AeroX2/esphome-fujitsu/pcb/esp-aircon.kicad_pcb

## KiCad design pcb/esp-aircon.kicad_pcb (2024-02-02)

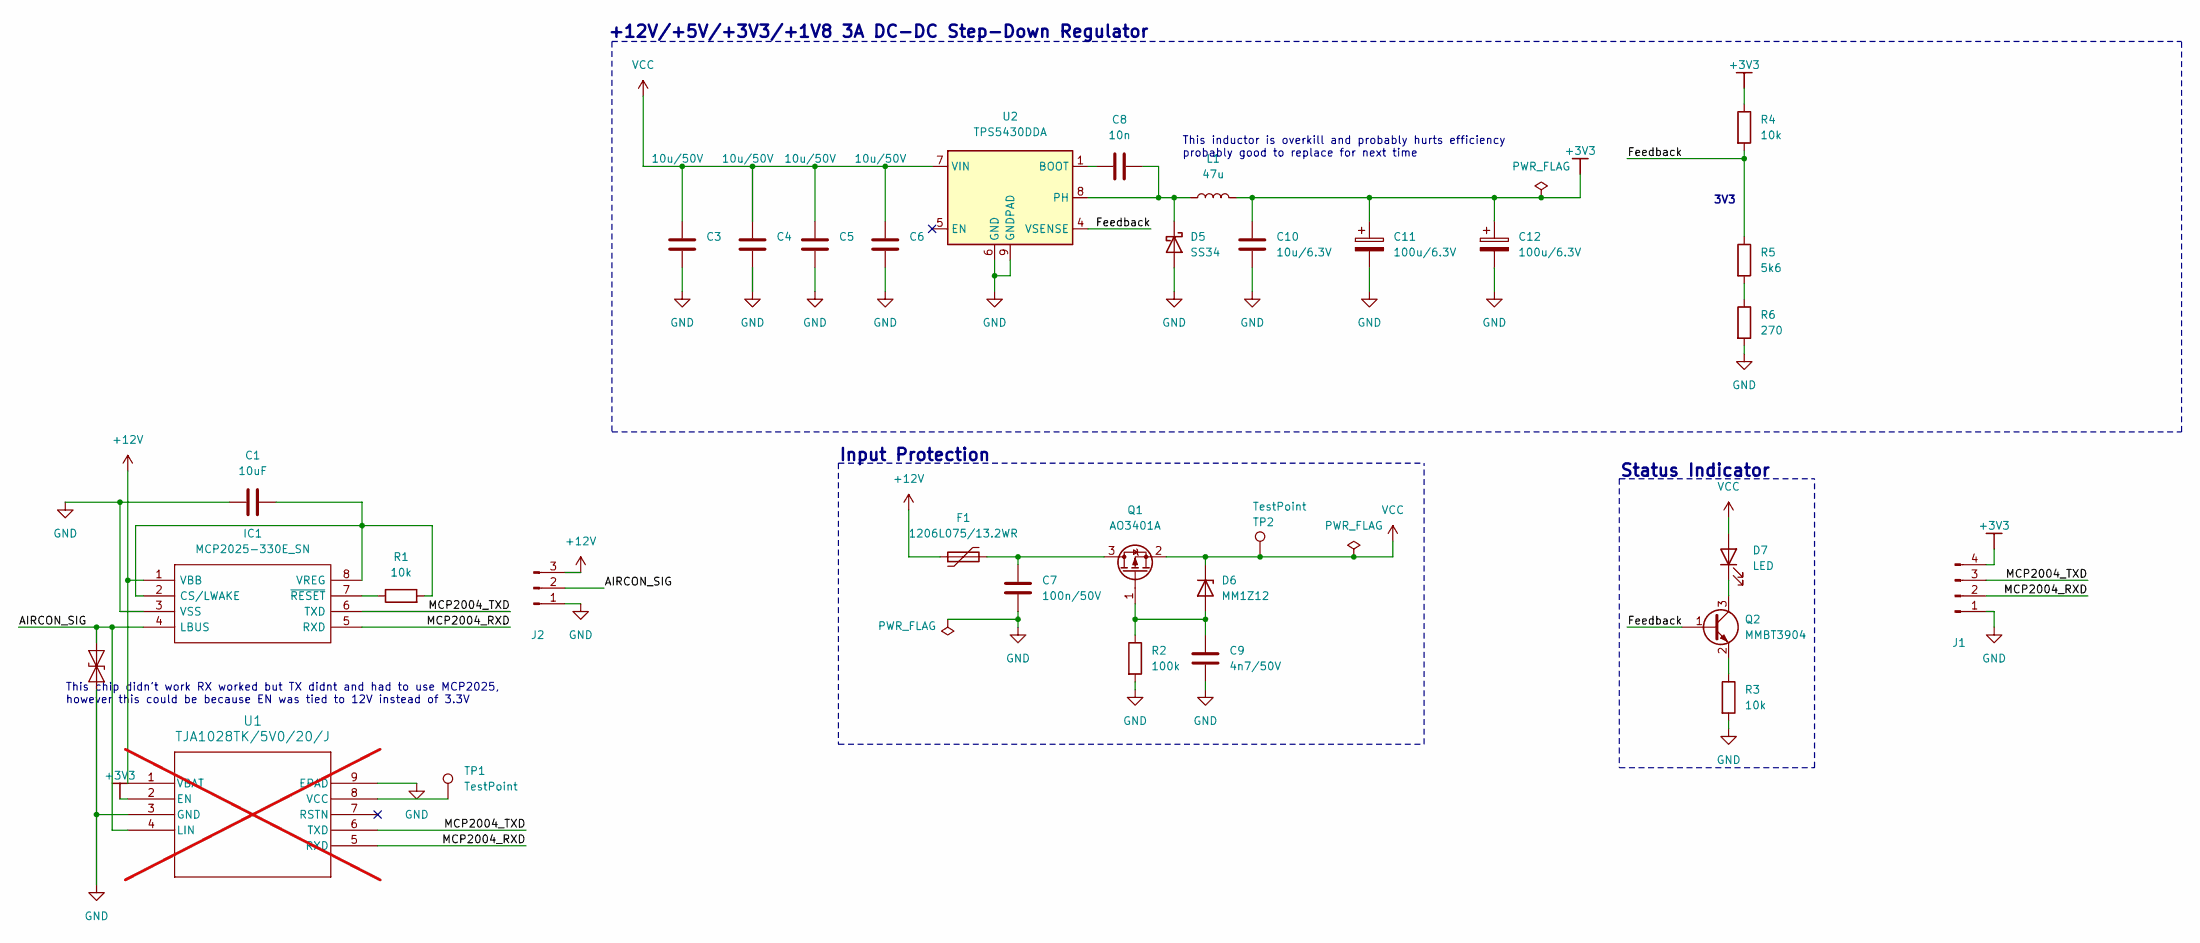
[picture p1: schematic esp-aircon.kicad_sch]

Parts:
C1: 10uF; C_1206_3216Metric
C3, C4, C5, C6: 10u/50V; C_1206_3216Metric; MPN CL31A106KBHNNNE; LCSC C13585
C7: 100n/50V; C_0603_1608Metric; MPN CC0603KRX7R9BB104; LCSC C14663
C8: 10n; C_0402_1005Metric; MPN CL05B103KB5NNNC; LCSC C15195
C9: 4n7/50V; C_0402_1005Metric; MPN 0402B472K500NT; LCSC C1538
C10: 10u/6.3V; C_0402_1005Metric; MPN CL05A106MQ5NUNC; LCSC C15525
C11, C12: 100u/6.3V; CP_EIA-3528-21_Kemet-B; MPN TAJB107K006RNJ; LCSC C16133
D1: PESD1IVN24; D_SOD-323
D5: SS34; D_SMA; MPN SS34; LCSC C8678
D6: MM1Z12; D_MiniMELF; MPN ZMM5V6; LCSC C8062
D7: LED; LED_0603_1608Metric; MPN 19-217/GHC-YR1S2/3T; LCSC C72043
F1: 1206L075/13.2WR; Fuse_1206_3216Metric; MPN 1206L300SLTHYR; LCSC C207041
IC1: MCP2025-330E_SN; SOIC127P600X175-8N; Manufacturer_Part_Number MCP2025-330E/SN; Mouser Part Number 579-MCP2025-330E/SN
J1: Conn_01x04_Pin; PinHeader_1x04_P2.54mm_Vertical
J2: Conn_01x03_Pin; PinHeader_1x03_P2.54mm_Vertical
L1: 47u; L_Sunlord_MWSA1004S_10x11.5x4mm; MPN MWSA1004S-470MT; LCSC C408491
Q1: AO3401A; SOT-23; MPN AO3401A; LCSC C15127
Q2: MMBT3904; SOT-23; MPN MMBT3904; LCSC C20526
R1: 10k; R_0402_1005Metric
R2: 100k; R_0402_1005Metric; MPN 0402WGF1003TCE; LCSC C25741
R3: 10k; R_0603_1608Metric; MPN 0603WAF1002T5E; LCSC C25804
R4: 10k; R_0402_1005Metric; MPN 0402WGF1002TCE; LCSC C25744
R5: 5k6; R_0603_1608Metric; MPN 0402WGF5601TCE; LCSC C25908
R6: 270; R_0603_1608Metric; MPN 0603WAF2700T5E; LCSC C22966
TP1, TP2: TestPoint; TestPoint_Pad_D1.5mm
U1: TJA1028TK/5V0/20/J; HVSON8_3X3_NXP; not fitted
U2: TPS5430DDA; TI_SO-PowerPAD-8_ThermalVias; MPN TPS5430DDAR; JLC LSOP-8_EP_3.9x4.9x1.27P

Connections:
+3V3: C10.1, C11.1, C12.1, J1.4, L1.2, R4.1, U1.2 (EN)
+12V: F1.1, IC1.1 (VBB), J2.3, U1.1 (VBAT)
/AIRCON_SIG: D1.2 (A2), IC1.4 (LBUS), J2.2, U1.4 (LIN)
/Feedback: Q2.1 (B), R4.2, R5.1, U2.4 (VSENSE)
/MCP2004_RXD: IC1.5 (RXD), J1.2, U1.5 (RXD)
/MCP2004_TXD: IC1.6 (TXD), J1.3, U1.6 (TXD)
GND: C1.1, C3.2, C4.2, C5.2, C6.2, C7.2, C9.2, C10.2, C11.2, C12.2, D1.1 (A1), D5.2 (A), IC1.3 (VSS), J1.1, J2.1, R2.2, R3.2, R6.2, U1.3 (GND), U1.9 (EPAD), U2.6 (GND), U2.9 (GNDPAD)
unnamed: C8.2, D5.1 (K), L1.1, U2.8 (PH)
unnamed: C9.1, D6.2 (A), Q1.1 (G), R2.1
unnamed: D7.1 (K), Q2.3 (C)
unnamed: C1.2, IC1.2 (CS/LWAKE), IC1.8 (VREG), R1.2
unnamed: IC1.7 (~RESET), R1.1
unnamed: C7.1, F1.2, Q1.3 (D)
unnamed: Q2.2 (E), R3.1
unnamed: R5.2, R6.1
unnamed: TP1.1, U1.8 (VCC)
unnamed: C8.1, U2.1 (BOOT)
VCC: C3.1, C4.1, C5.1, C6.1, D6.1 (K), D7.2 (A), Q1.2 (S), TP2.1, U2.7 (VIN)

Notes on the sheet:
Input Protection
This inductor is overkill and probably hurts efficiency probably good to replace for next time
3V3
Status Indicator
This chip didn't work RX worked but TX didnt and had to use MCP2025, however this could be because EN was tied to 12V instead of 3.3V
+12V/+5V/+3V3/+1V8 3A DC-DC Step-Down Regulator

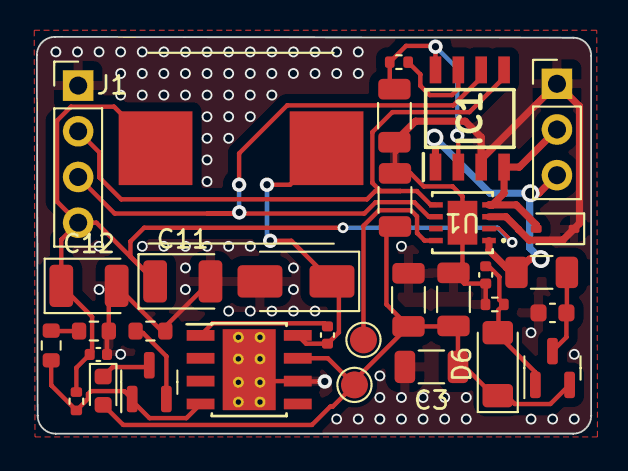
[picture p2: board esp-aircon.kicad_pcb from above]

Board: 2 copper layers, 30.8 x 22.0 mm, 32 parts (0 on the bottom side), 18 nets.
