AeroX2/esphome-fujitsu/(commit log)

2024-02-02 Finally got it working
    [partitions.csv]
2024-02-02 Add PCB
    [esp-aircon.kicad_pcb, esp-aircon.kicad_sch]
